lerouxb/disqo/pcb/3d/BM02B-ACHSS-GAN-TF-LF--SN---3DModel-STEP-269445.STEP

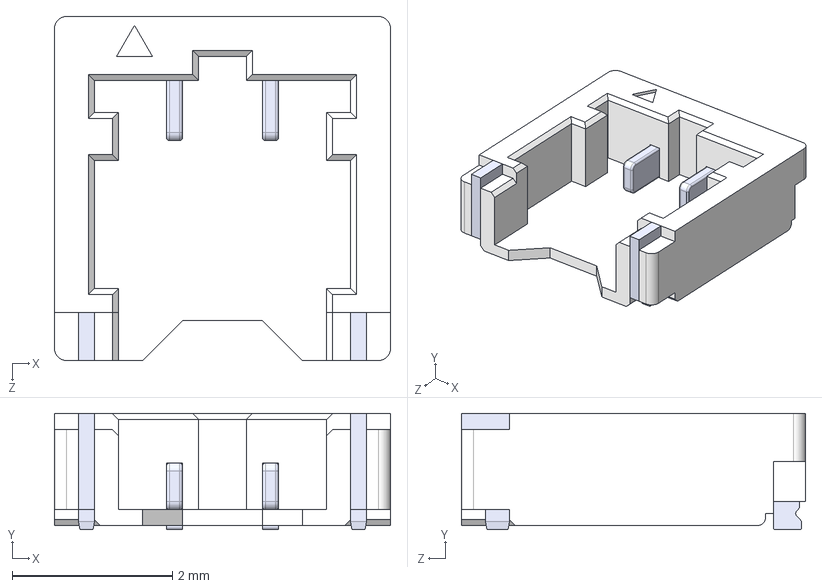
[picture p2: CAD file, 2023-01-21]
pcb/3d/BM02B-ACHSS-GAN-TF-LF--SN---3DModel-STEP-269445.STEP
4.20 x 1.45 x 4.30 mm
