lerouxb/disqo/pcb/3d/ESP32-PICO-MINI-02--3DModel-STEP-1.STEP

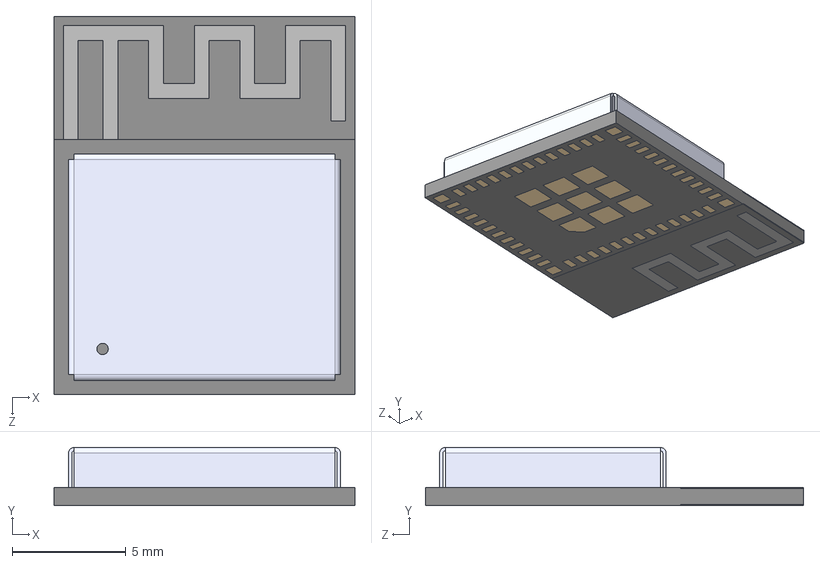
[picture p3: CAD file, 2023-01-21]
pcb/3d/ESP32-PICO-MINI-02--3DModel-STEP-1.STEP
13.2 x 2.55 x 16.6 mm
