lerouxb/disqo/pcb/3d/PKMCS0909E4000-R1.step

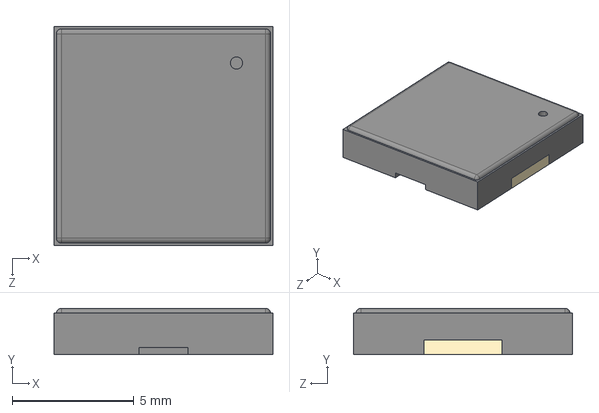
[picture p4: CAD file, 2022-10-24]
pcb/3d/PKMCS0909E4000-R1.step
9.00 x 1.90 x 9.00 mm
