lerouxb/disqo/pcb/3d/USB4105--3DModel-STEP-56544.STEP

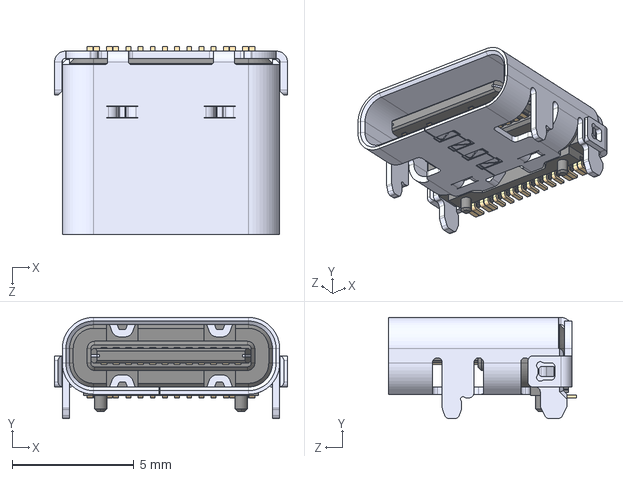
[picture p5: CAD file, 2022-10-24]
pcb/3d/USB4105--3DModel-STEP-56544.STEP
9.58 x 4.16 x 7.71 mm
