lerouxb/disqo/pcb/3d/KXT311LHS_CNK.step

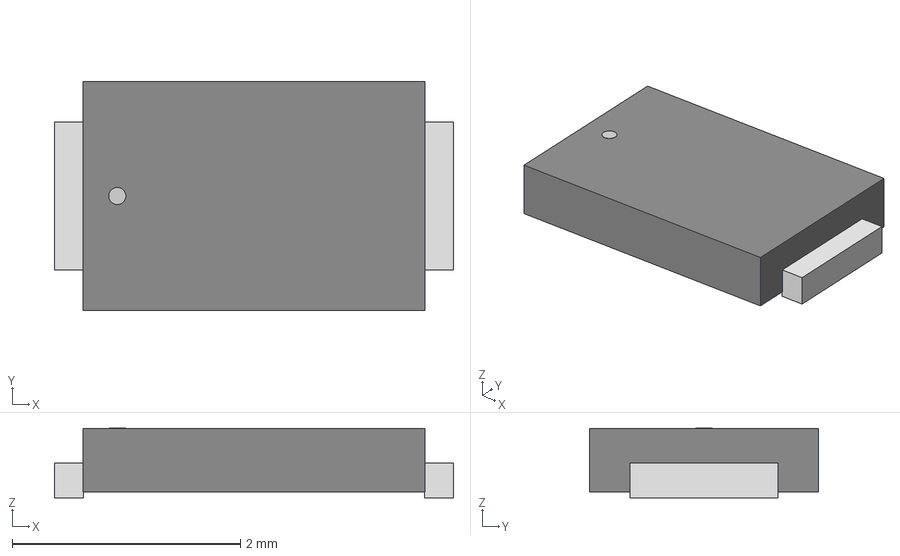
[picture p6: CAD file, 2022-10-24]
pcb/3d/KXT311LHS_CNK.step
3.50 x 2.01 x 0.612 mm
