lerouxb/disqo/pcb/3d/KXT311LHS.stp

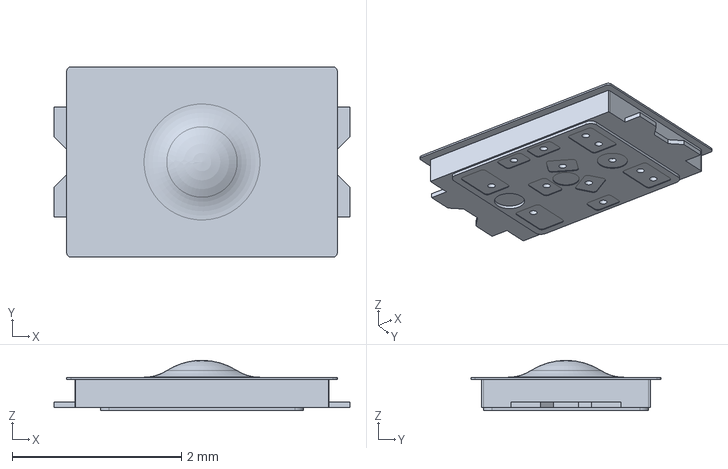
[picture p7: CAD file, 2022-10-24]
pcb/3d/KXT311LHS.stp
3.50 x 2.25 x 0.595 mm
