lerouxb/disqo/pcb/3d/2450AT42E0100E.step

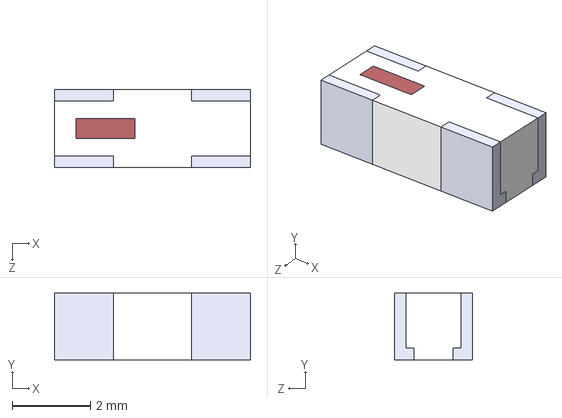
[picture p8: CAD file, 2022-10-24]
pcb/3d/2450AT42E0100E.step
5.00 x 1.70 x 2.00 mm
