lerouxb/disqo/pcb/3d/EVP-AKE31A--3DModel-STEP-56544.STEP

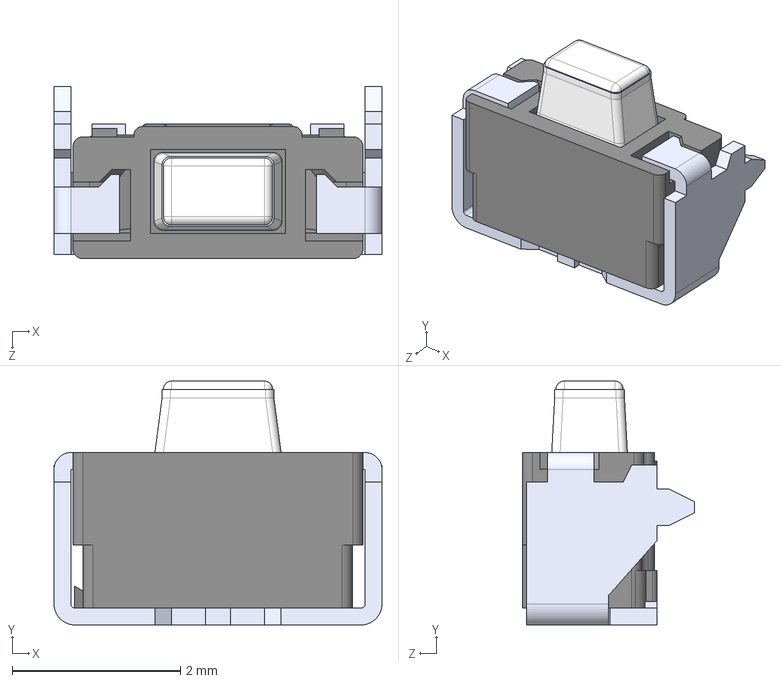
[picture p9: CAD file, 2022-10-24]
pcb/3d/EVP-AKE31A--3DModel-STEP-56544.STEP
3.90 x 2.90 x 2.05 mm
