lerouxb/disqo/pcb/disqo.kicad_pcb

## KiCad design pcb/disqo.kicad_pcb (2023-07-28)

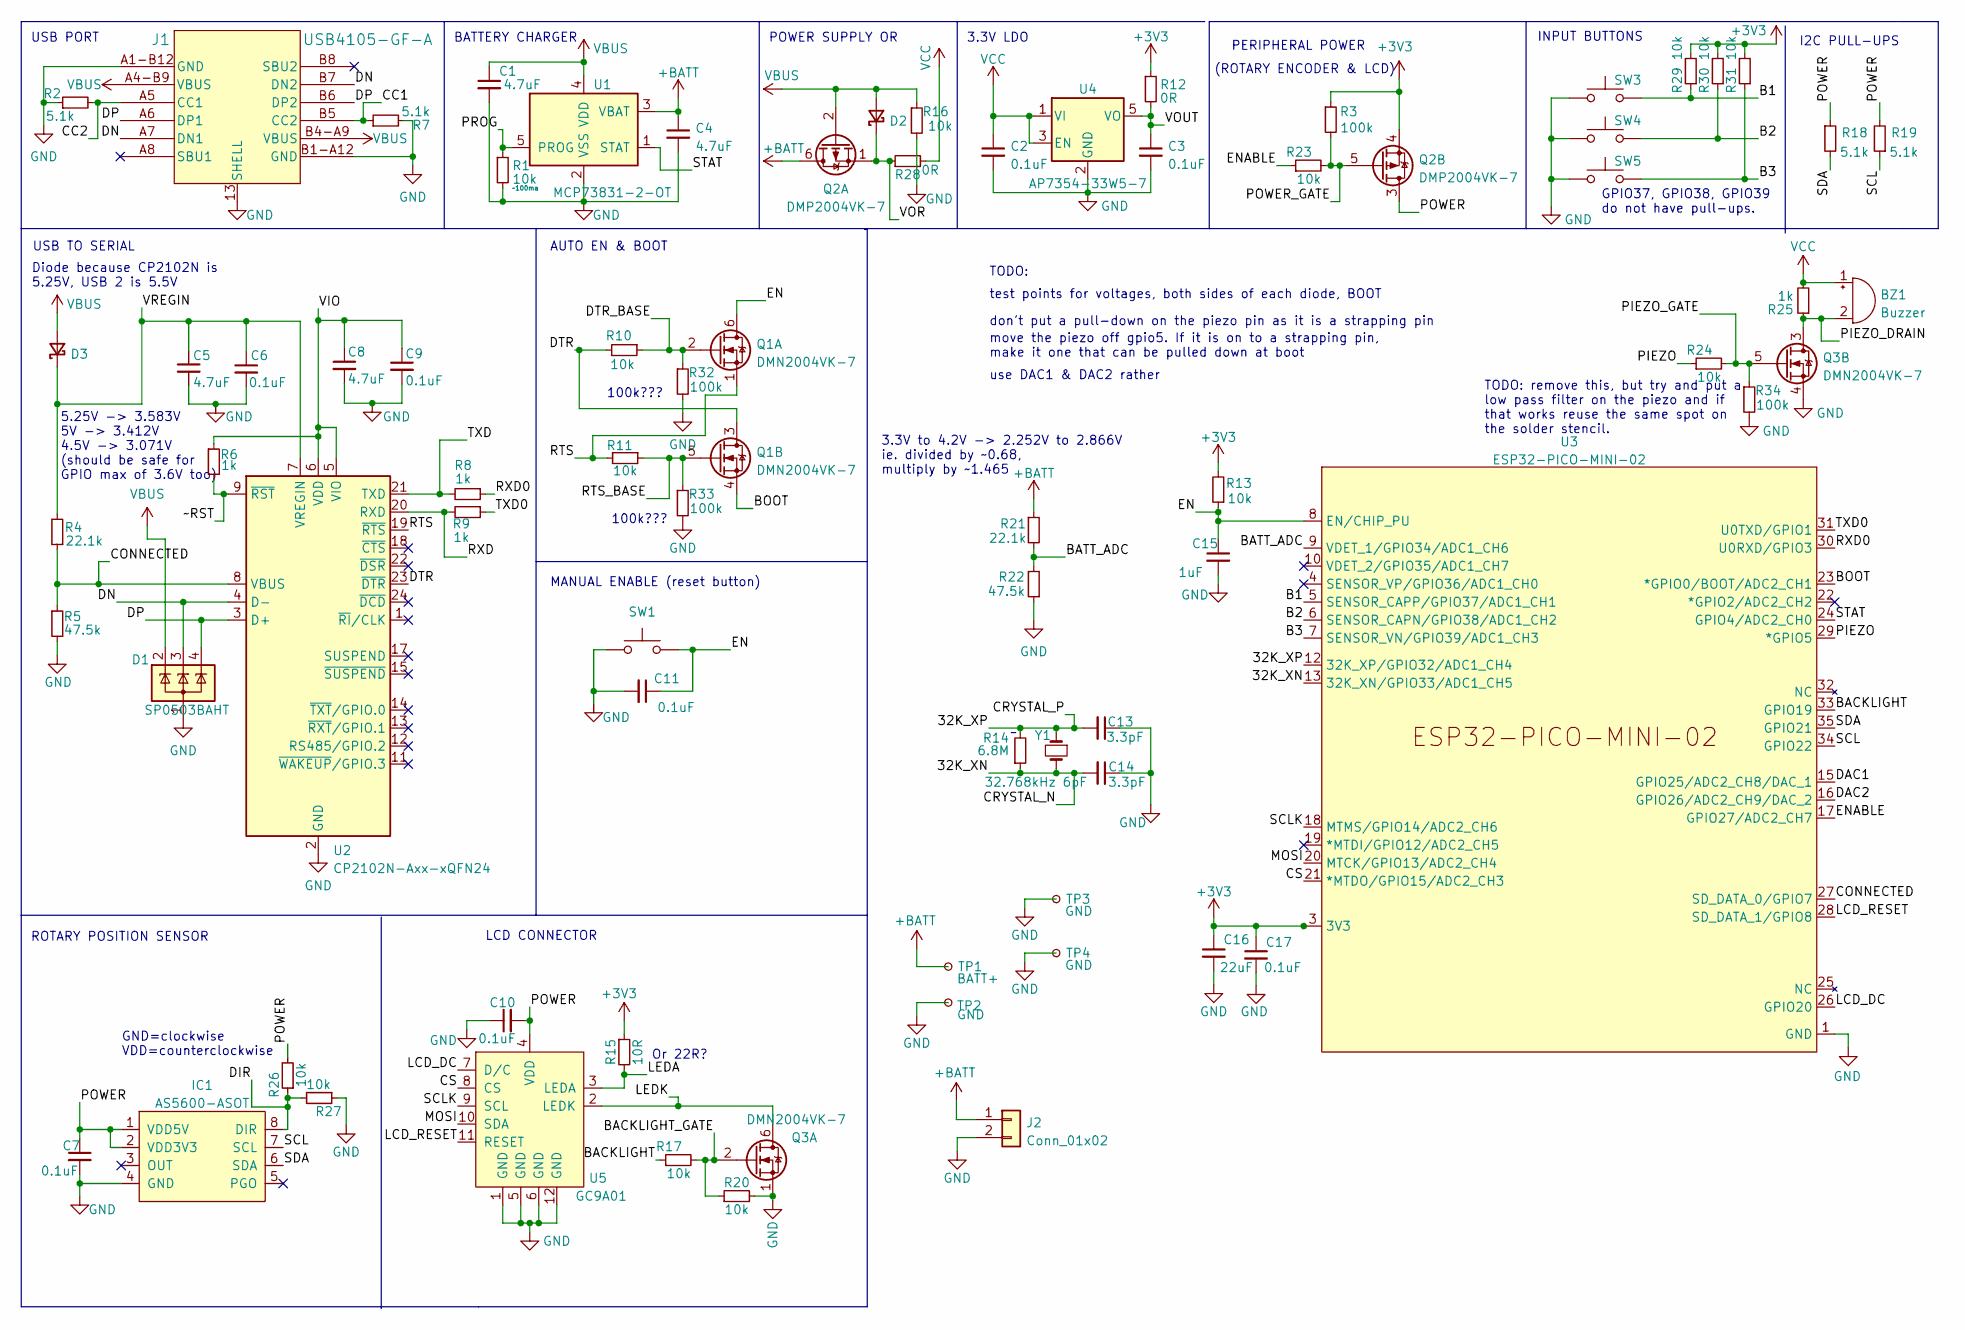
[picture p10: schematic disqo.kicad_sch]

Parts:
BZ1: Buzzer; SPKR_PKMCS0909E4000-R1
C1, C4, C5, C8: 4.7uF; C_0805_2012Metric
C2, C3, C6, C7, C9, C10, C11, C17: 0.1uF; C_0402_1005Metric
C13, C14: 3.3pF; C_0603_1608Metric
C15: 1uF; C_0603_1608Metric
C16: 22uF; C_0805_2012Metric
D1: SP0503BAHT; SOT-143
D2, D3: D_Schottky_Small; D_SOD-323
IC1: AS5600-ASOT; SOIC-8_3.9x4.9mm_P1.27mm; MOUSER_PART_NUMBER 985-AS5600-ASOT
J1: USB4105-GF-A
J2: Conn_01x02; JST_ACH_BM02B-ACHSS-GAN-ETF_1x02-1MP_P1.20mm_Vertical
Q1, Q3: DMN2004VK-7; SOT-563
Q2: DMP2004VK-7; SOT-563
R1, R10, R11, R13, R16, R17, R20, R23, R24, R26, R27, R29, R30, R31: 10k; R_0402_1005Metric
R2, R7, R18, R19: 5.1k; R_0402_1005Metric
R3, R32, R33, R34: 100k; R_0402_1005Metric
R4, R21: 22.1k; R_0402_1005Metric
R5, R22: 47.5k; R_0402_1005Metric
R6, R8, R9, R25: 1k; R_0402_1005Metric
R12, R28: 0R; R_0805_2012Metric
R14: 6.8M; R_0603_1608Metric
R15: 10R; R_0402_1005Metric
SW1: top-switch; KXT 311 LHS
SW3, SW4, SW5: side-switch; EVP-AKE31A
TP1: BATT+; TestPoint_THTPad_D1.5mm_Drill0.7mm
TP2: GND; TestPoint_THTPad_D1.5mm_Drill0.7mm
TP3, TP4: GND; tab
U1: MCP73831-2-OT; SOT-23-5
U2: CP2102N-Axx-xQFN24; QFN-24-1EP_4x4mm_P0.5mm_EP2.6x2.6mm
U3: ESP32-PICO-MINI-02; ESP32-PICO-MINI-02_Hand-Soldering
U4: AP7354-33W5-7; SOT-25
U5: GC9A01; GC9A01_IPS_display_under
Y1: 32.768kHz 6pF; Crystal_SMD_3215-2Pin_3.2x1.5mm

Connections:
+3V3: C16.1, C17.1, Q2.4 (S), R3.1, R12.1, R13.2, R15.1, R29.2, R30.2, R31.2, U3.3 (3V3)
+BATT: C4.1, J2.1, Q2.6 (D), R21.1, TP1.1, U1.3 (VBAT)
/32K_XN: C14.2, R14.1, U3.13 (32K_XN/GPIO33/ADC1_CH5), Y1.2
/32K_XP: C13.2, R14.2, U3.12 (32K_XP/GPIO32/ADC1_CH4), Y1.1
/B1: R29.1, SW3.1, U3.5 (SENSOR_CAPP/GPIO37/ADC1_CH1)
/B2: R30.1, SW4.1, U3.6 (SENSOR_CAPN/GPIO38/ADC1_CH2)
/B3: R31.1, SW5.2, U3.7 (SENSOR_VN/GPIO39/ADC1_CH3)
/BACKLIGHT: R17.1, U3.33 (GPIO19)
/BACKLIGHT_GATE: Q3.2 (G), R17.2, R20.1
/BATT_ADC: R21.2, R22.2, U3.9 (VDET_1/GPIO34/ADC1_CH6)
/BOOT: Q1.4 (S), U3.23 (*GPIO0/BOOT/ADC2_CH1)
/CC1: J1.B5 (CC2), R7.1
/CC2: J1.A5 (CC1), R2.2
/CONNECTED: R4.1, R5.1, U2.8 (VBUS), U3.27 (SD_DATA_0/GPIO7)
/CS: U3.21 (*MTDO/GPIO15/ADC2_CH3), U5.8 (CS)
/DAC1: U3.15 (GPIO25/ADC2_CH8/DAC_1)
/DAC2: U3.16 (GPIO26/ADC2_CH9/DAC_2)
/DIR: IC1.8 (DIR), R26.1, R27.2
/DN: D1.3 (K), J1.A7 (DN1), J1.B7 (DN2), U2.4 (D-)
/DP: D1.4 (K), J1.A6 (DP1), J1.B6 (DP2), U2.3 (D+)
/DTR: Q1.3 (D), R10.2, U2.23 (~DTR)
/DTR_BASE: Q1.2 (G), R10.1, R32.1
/EN: C11.1, C15.1, Q1.6 (D), R13.1, SW1.2, U3.8 (EN/CHIP_PU)
/ENABLE: R23.1, U3.17 (GPIO27/ADC2_CH7)
/LCD_DC: U3.26 (GPIO20), U5.7 (D/C)
/LCD_RESET: U3.28 (SD_DATA_1/GPIO8), U5.11 (RESET)
/LEDA: R15.2, U5.3 (LEDA)
/LEDK: Q3.6 (D), U5.2 (LEDK)
/MOSI: U3.20 (MTCK/GPIO13/ADC2_CH4), U5.10 (SDA)
/PIEZO: R24.1, U3.29 (*GPIO5)
/PIEZO_DRAIN: BZ1.2 (+), Q3.3 (D), R25.1
/PIEZO_GATE: Q3.5 (G), R24.2, R34.1
/POWER: C7.1, C10.2, IC1.1 (VDD5V), IC1.2 (VDD3V3), Q2.3 (D), R18.1, R19.2, R26.2, U5.4 (VDD)
/POWER_GATE: Q2.5 (G), R3.2, R23.2
/PROG: R1.1, U1.5 (PROG)
/RTS: Q1.1 (S), R11.2, U2.19 (~RTS)
/RTS_BASE: Q1.5 (G), R11.1, R33.1
/RXD: R9.2, U2.20 (RXD)
/RXD0: R8.1, U3.30 (U0RXD/GPIO3)
/SCL: IC1.7 (SCL), R19.1, U3.34 (GPIO22)
/SCLK: U3.18 (MTMS/GPIO14/ADC2_CH6), U5.9 (SCL)
/SDA: IC1.6 (SDA), R18.2, U3.35 (GPIO21)
/STAT: U1.1 (STAT), U3.24 (GPIO4/ADC2_CH0)
/TXD: R8.2, U2.21 (TXD)
/TXD0: R9.1, U3.31 (U0TXD/GPIO1)
/VIO: C8.1, C9.1, R6.1, U2.5 (VIO), U2.6 (VDD)
/VOR: D2.1 (K), Q2.1 (S), R28.1
/VOUT: C3.1, R12.2, U4.5 (VO)
/VREGIN: C5.1, C6.1, D3.1 (K), R4.2, U2.7 (VREGIN)
/~RST: R6.2, U2.9 (~RST)
GND: C1.2, C2.2, C3.2, C4.2, C5.2, C6.2, C7.2, C8.2, C9.2, C10.1, C11.2, C13.1, C14.1, C15.2, C16.2, C17.2, D1.1 (A), IC1.4 (GND), J1.13 (SHELL), J1.A1-B12 (GND), J1.B1-A12 (GND), J2.2, Q3.1 (S), Q3.4 (S), R1.2, R2.1, R5.2, R7.2, R16.2, R20.2, R22.1, R27.1, R32.2, R33.2, R34.2, SW1.1, SW3.2, SW4.2, SW5.1, TP2.1, TP3.1, TP4.1, U1.2 (VSS), U2.2 (GND), U2.25 (GND), U3.1 (GND), U3.2 (GND), U3.11 (GND), U3.14 (GND), U3.36 (GND), U4.2 (GND), U5.1 (GND), U5.5 (GND), U5.6 (GND), U5.12 (GND)
VBUS: C1.1, D1.2 (K), D2.2 (A), D3.2 (A), J1.A4-B9 (VBUS), J1.B4-A9 (VBUS), Q2.2 (G), R16.1, U1.4 (VDD)
VCC: BZ1.1 (-), C2.1, R25.2, R28.2, U4.1 (VI), U4.3 (EN)

Notes on the sheet:
POWER SUPPLY OR
use DAC1 & DAC2 rather
PERIPHERAL POWER
GPIO37, GPIO38, GPIO39 do not have pull-ups.
INPUT BUTTONS
3.3V LDO
(ROTARY ENCODER & LCD)
move the piezo off gpio5. If it is on to a strapping pin, make it one that can be pulled down at boot
5.25V -> 3.583V 5V -> 3.412V 4.5V -> 3.071V (should be safe for GPIO max of 3.6V too)
I2C PULL-UPS
100k???
USB TO SERIAL
TODO: remove this, but try and put a low pass filter on the piezo and if that works reuse the same spot on the solder stencil.
LCD CONNECTOR
AUTO EN & BOOT
Or 22R?
BATTERY CHARGER
don't put a pull-down on the piezo pin as it is a strapping pin
USB PORT
GND=clockwise VDD=counterclockwise
MANUAL ENABLE (reset button)
3.3V to 4.2V -> 2.252V to 2.866V ie. divided by ~0.68, multiply by ~1.465
test points for voltages, both sides of each diode, BOOT
Diode because CP2102N is 5.25V, USB 2 is 5.5V
ROTARY POSITION SENSOR
TODO:

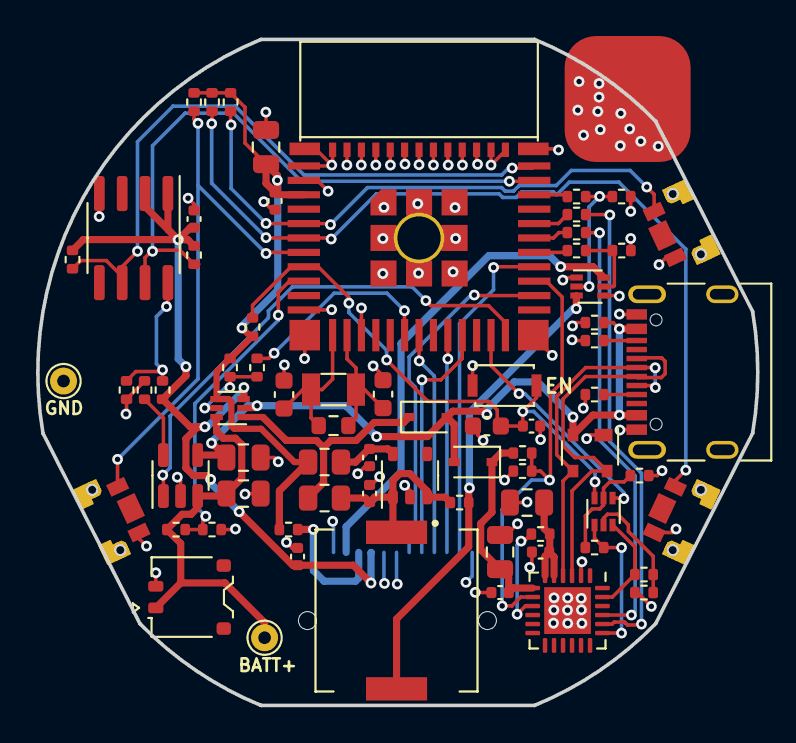
[picture p11: board disqo.kicad_pcb from above]

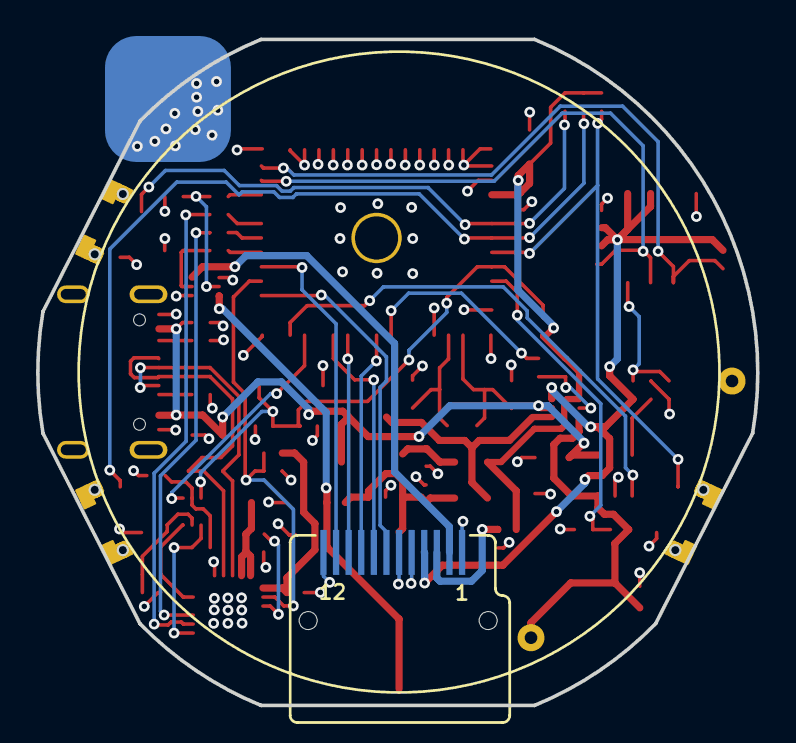
[picture p12: board disqo.kicad_pcb from below]

Board: 4 copper layers, 40.0 x 37.0 mm, 74 parts (2 on the bottom side), 51 nets.
