lerouxb/disqo/(commit log)

2022-10-27 panelized, fixes
    [panel-B_Cu.gbr, panel-B_Mask.gbr, panel-B_Paste.gbr, panel-B_Silkscreen.gbr, panel-Edge_Cuts.gbr, panel-F_Cu.gbr, panel-F_Mask.gbr, panel-F_Paste.gbr]
2022-12-24 PCB tweaks
    [disqo.kicad_sch]
2023-01-21 pcb changes
    [BM02B-ACHSS-GAN-TF-LF--SN---3DModel-STEP-269445.STEP, ESP32-PICO-MINI-02--3DModel-STEP-1.STEP, disqo.kicad_pcb, disqo.kicad_sch]
